alipasaoksuz/RSSI-based-outdoor-localization-system/Test Alanı.jpg

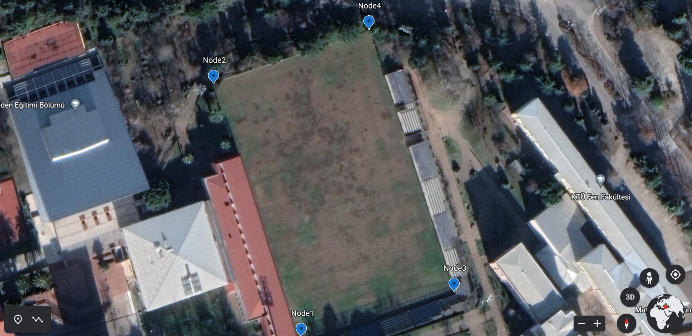
Test Alanı.jpg
