alipasaoksuz/RSSI-based-outdoor-localization-system/README.md

# RSSI-based-outdoor-localization-system
 KTU EEE graduation project: RSSI-based-outdoor-localization-system
