alipasaoksuz/RSSI-based-outdoor-localization-system/RSSI Tabanlı Konum Tespit Cihazı - Tez.pdf

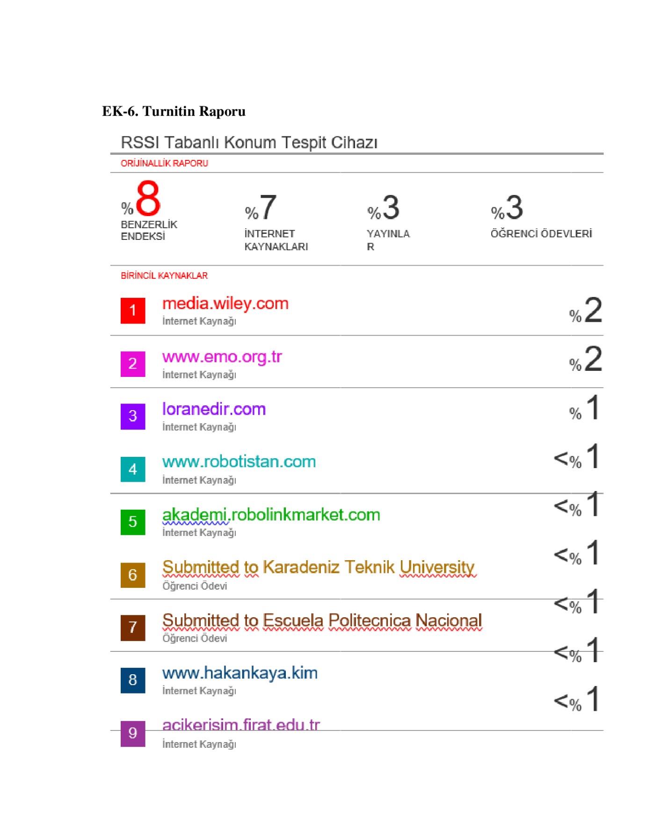
[picture p69: figure]
