alipasaoksuz/RSSI-based-outdoor-localization-system/RSSI Tabanlı Konum Tespit Cihazı - Poster.pdf

İnsanlar nerede olduğunu merak eder. Şimdiye kadar bu soruna çözüm olarak geliştirilen cihazlar genellikle Küresel Navigasyon Uydu Sistemleri (GNSS) tabanlı konum tespitini kullanmıştır. Teknolojinin gelişmesiyle maliyet düşümü sağlanırken, haberleşme teknolojilerindeki gelişmeyle de düşük güç tüketime dayalı yeni haberleşme protokolleri geliştirilmiştir. Bu gelişmelerle konum tespit uygulamalarında da farklı teknolojilerin gelişmesine fırsat doğmuştur. Yapılan bu projede LoRa ile ESP32 haberleşmesiyle çalışacak olan cihazlar üretilmiştir. Bu cihazların birbirleriyle haberleşmesi sayesinde konumu bilinmiş olacaktır.

# ÖZET

Hayvansal gıdaların ve hayvansal ürünlerin elde edilmesine yönelik olarak yapılan hayvan yetiştirilmesi, beslenmesi ve bakımını kapsayan tarım kolu genel olarak hayvancılık olarak adlandırılır. Günümüzde birçok insan büyükbaş hayvan yetiştiriciliği yapmaktadır. Günümüzde köylülerin bu hayvanlarının çalınma, kaybolma korkusu eklenince üretici iyice bu işlere girişmekte çekinmektedir. Bu duruma çözüm olarak konum tespit cihazları geliştirilmiştir. Bu projede kullandığımız RSSI hesaplayabilen LoRa modülleri ise bu yeni teknolojilerden biridir. Yapılan bu projede LoRa ile ESP32 haberleşmesiyle çalışacak olan cihazdan en az 5 adet üretilecektir. 4’ünün koordinatı belli, sabit şekilde duracaktır. Konumu bilinmek istenen hayvana konulacak 5. cihaz sabit cihazlarla haberleşecektir. Bu haberleşme anında sinyalin diğer alıcılara ulaştığı andaki güç değerleriyle de içerisindeki algoritma sayesinde 5. cihazın konumu hesaplanacaktır. Bu sayede konumu bilinmiş olacaktır. LoRa haberleşmesi her ne kadar yeni bir teknoloji olsa da gittikçe yaygınlaşan IoT sistemlerin hayatımıza girmesiyle birlikte bu yükseliş ivmesini arttırmasını beklediğimiz bir teknolojidir.

# RSSI Tabanlı Konum Tespit Cihazı

Trilaterasyon yöntemi açık alanlarda veya kapalı alanlarda takip edilmek istenen cihazın konumunu belirlemede kullanılan yöntemlerden biridir. Sistemin hedef cihazın konumunu başarılı bir şekilde bulabilmesi için bazı verilerin önceden bilinmesi gerekir. Bu veriler verici durumunda düğümlerin koordinatları ve alıcı (hedef) cihaz ile arasındaki mesafe bilgisidir. 3 boyutlu bir konum tespiti yapılması için en az dört verici cihazın konumu ve hedef cihaza olan uzaklığı bilinmelidir.

# GİRİŞ

### Proje Danışmanı: Prof. Dr. Temel KAYIKÇIOĞLU tkayikci@ktu.edu.tr

### Alipaşa ÖKSÜZ alipasaoksuz@gmail.com

### Furkan BİLGE furkan.bilgee2861@gmail.com

# TASARIM

# KONU

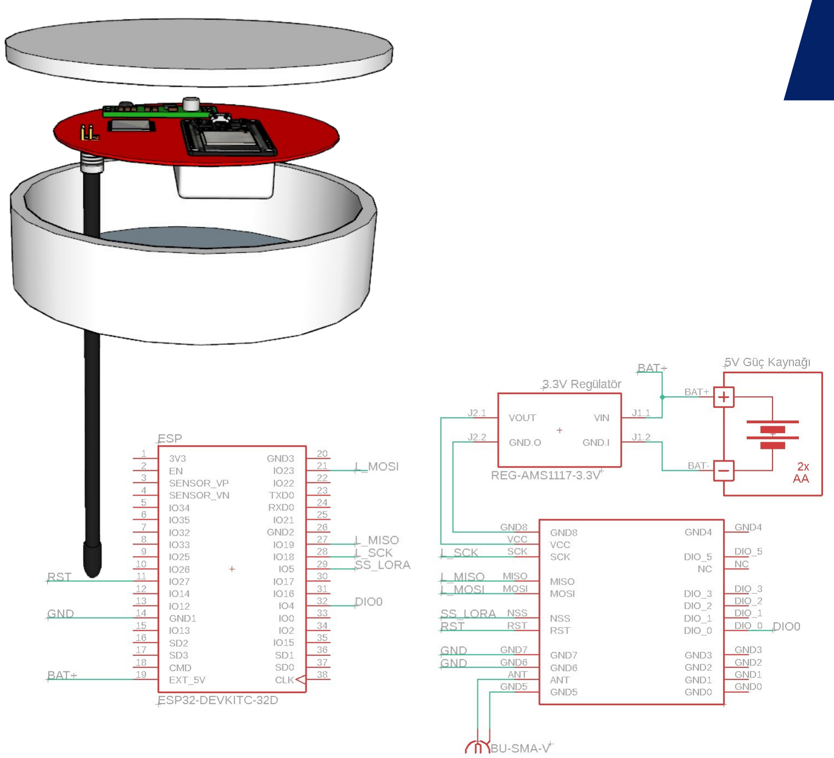
[picture p15: figure]

# SİMÜLASYON SONUÇLARI

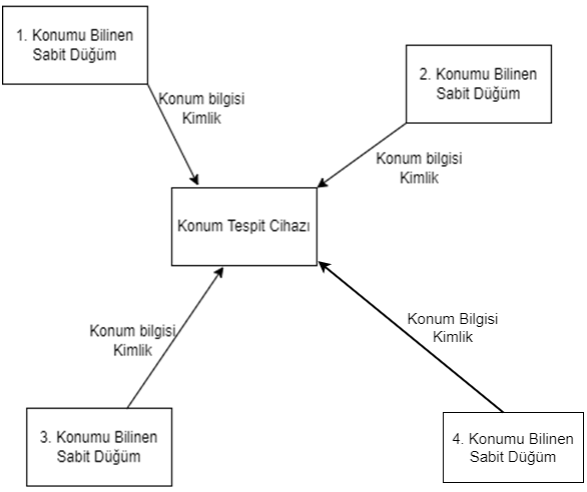
[picture p16: figure]
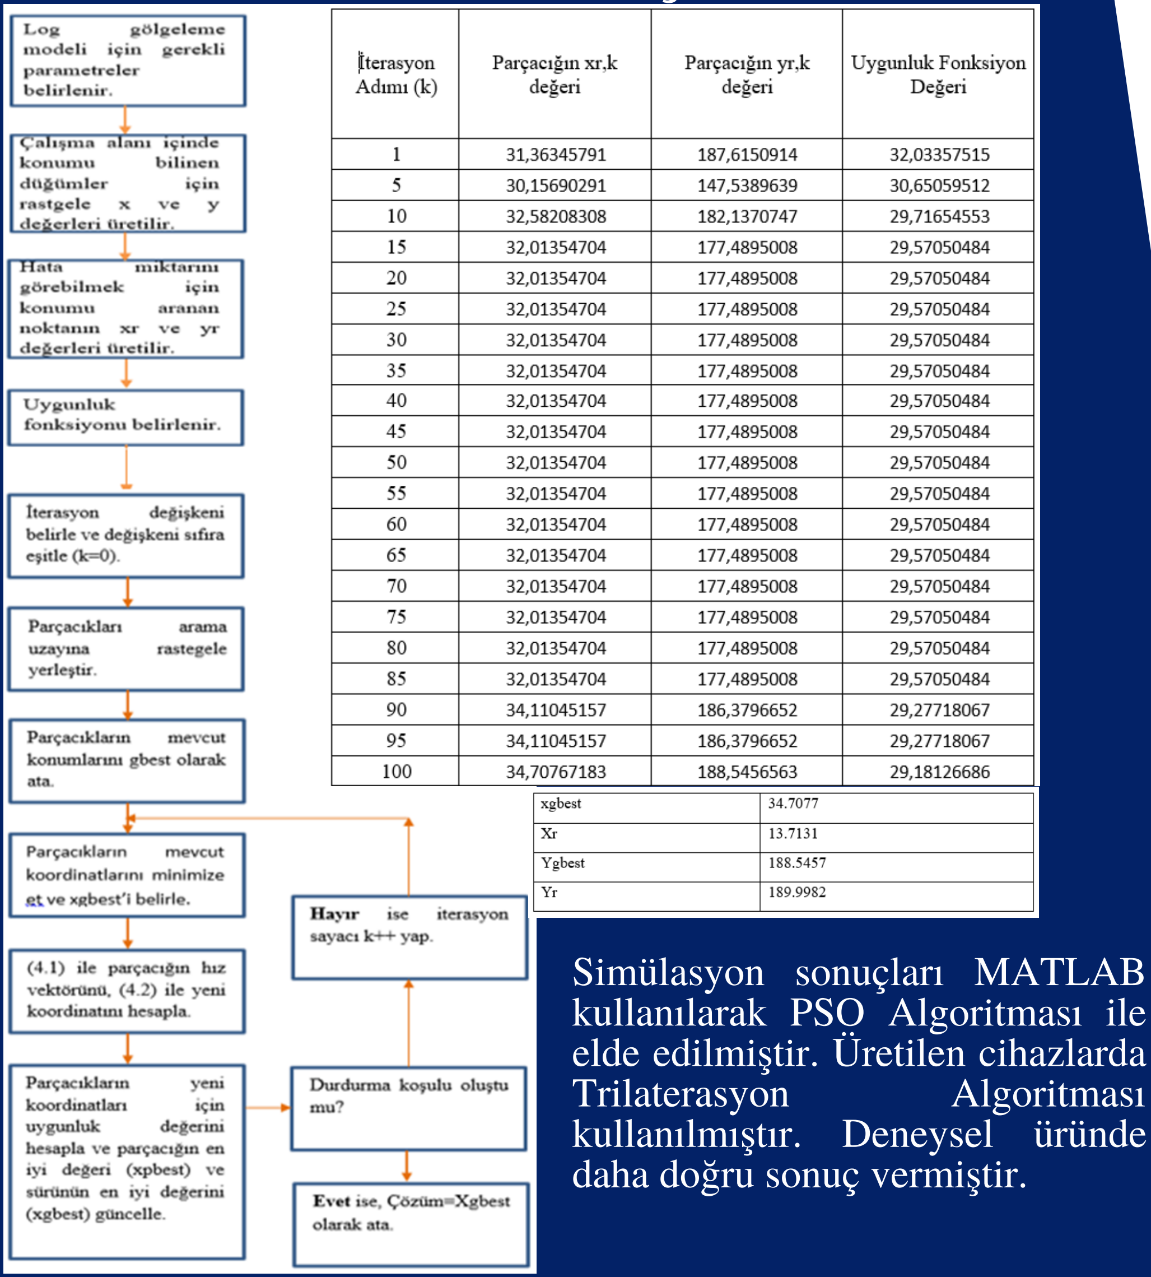
[picture p17: figure]
Simülasyon sonuçları MATLAB kullanılarak PSO Algoritması ile elde edilmiştir. Üretilen cihazlarda; Trilaterasyon; Algoritması; kullanılmıştır. Deneysel üründe daha doğru sonuç vermiştir.

# DENEYSEL BAĞLANTI DİYAGRAMLARI

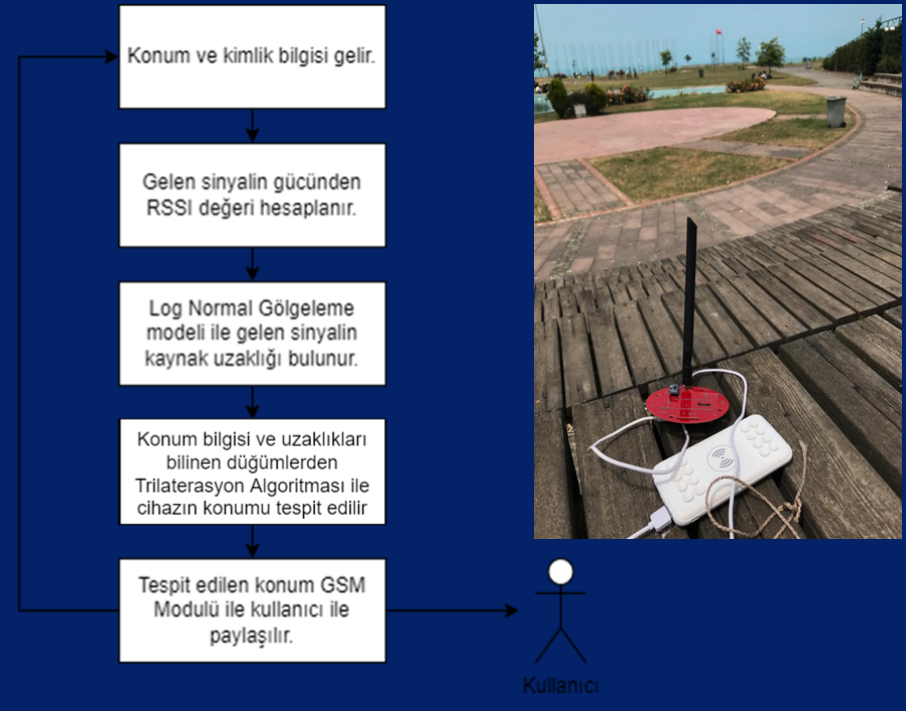
[picture p18: figure]
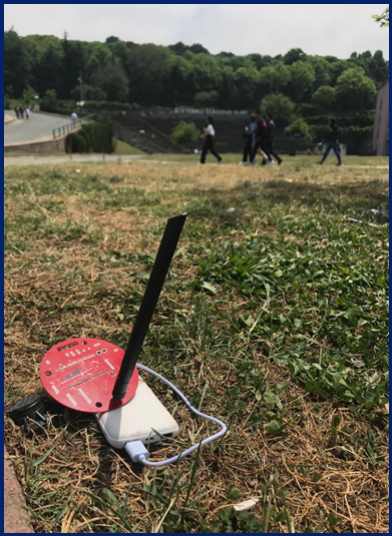
[picture p19: figure]

# DEĞERLENDİRME

Bu çalışma ile GPS, GLONASS, Galileo ve BeiDou gibi GNSS sistemleri hakkında bilgiler elde edildi. Lokal Konum Tespiti uygulamaları hakkında literatür araştırmalar yapıldı. Bu uygulamaları kullanarak RF haberleşme, mikrodenetleyiciler, gömülü yazılım hakkında deneyim elde edildi. Testler başarılı şekilde gerçekleştirildi ve raporlandı. Daha geniş kapsamlı testler yapılarak cihaz konum doğruluğu hakkında daha net ölçümlerden sonra piyasada yer alabilecek bir ürün olacağı düşünülmektedir.
